Jed0vcela/Gas-Flow-Control-and-Logging-System/hydrogen - KiCad, 3D files/3D - lab assembly/spojka.png

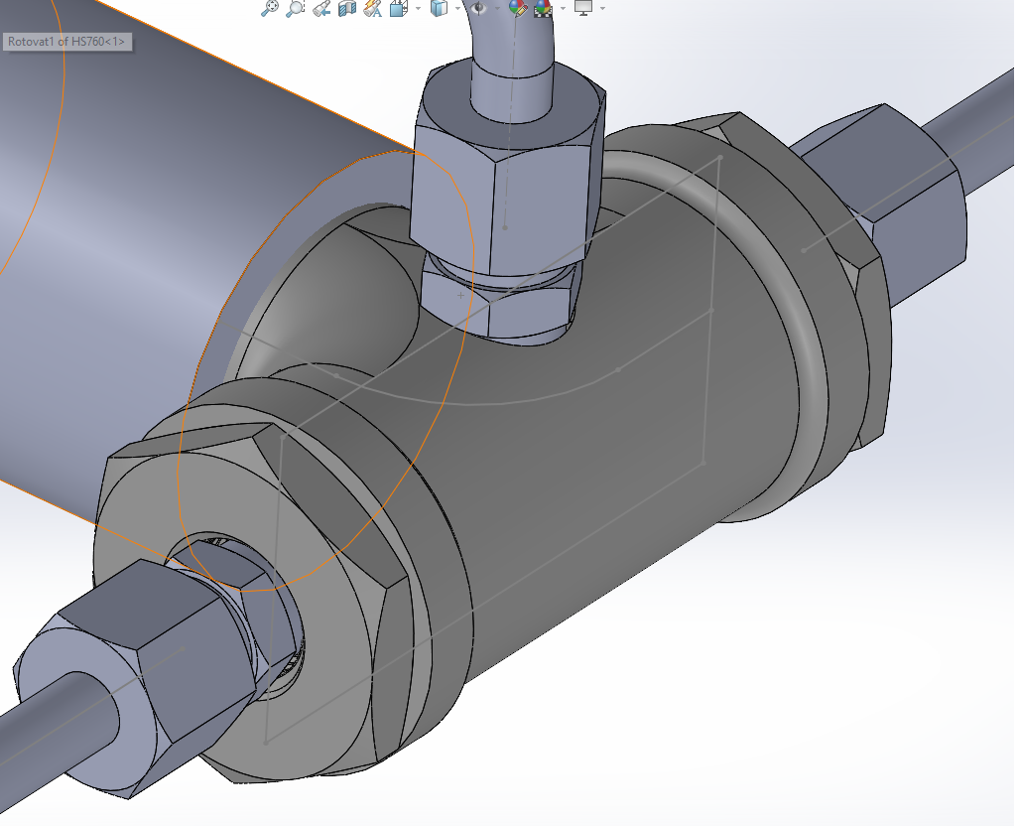
hydrogen - KiCad, 3D files/3D - lab assembly/spojka.png
