Jed0vcela/Gas-Flow-Control-and-Logging-System/hydrogen - KiCad, 3D files/3D - lab assembly/sestava.png

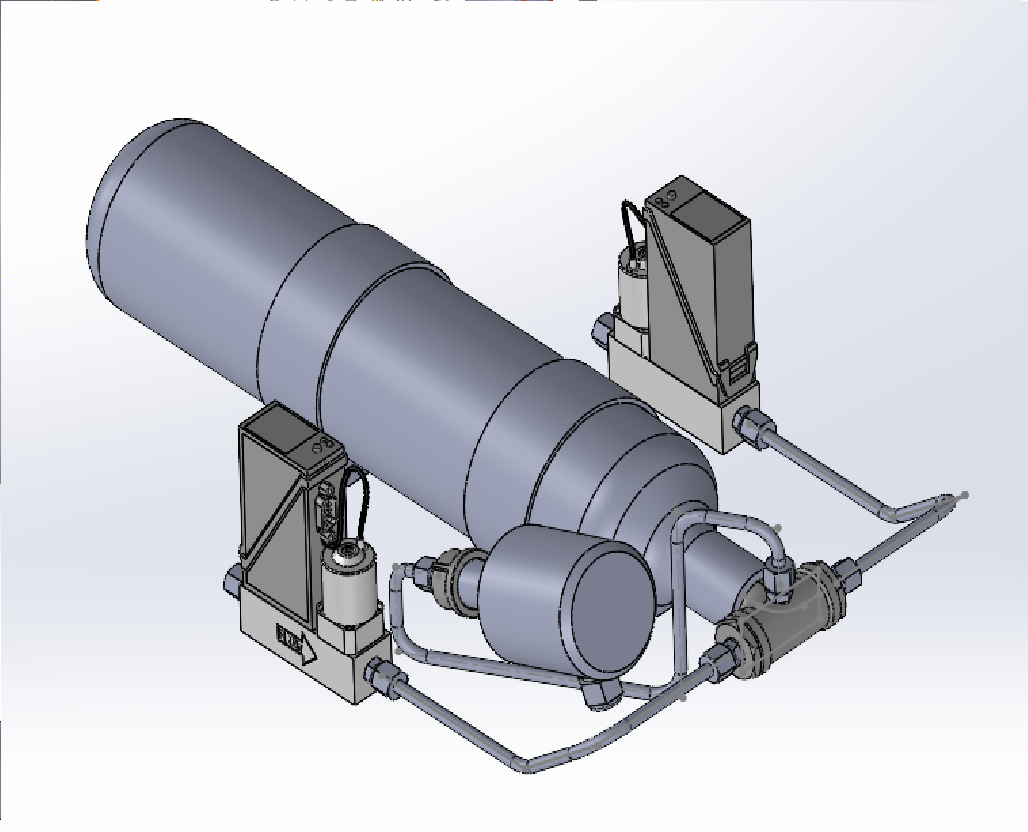
hydrogen - KiCad, 3D files/3D - lab assembly/sestava.png
