Jed0vcela/Gas-Flow-Control-and-Logging-System/hydrogen - KiCad, 3D files/3D - lab assembly/base.SLDPRT

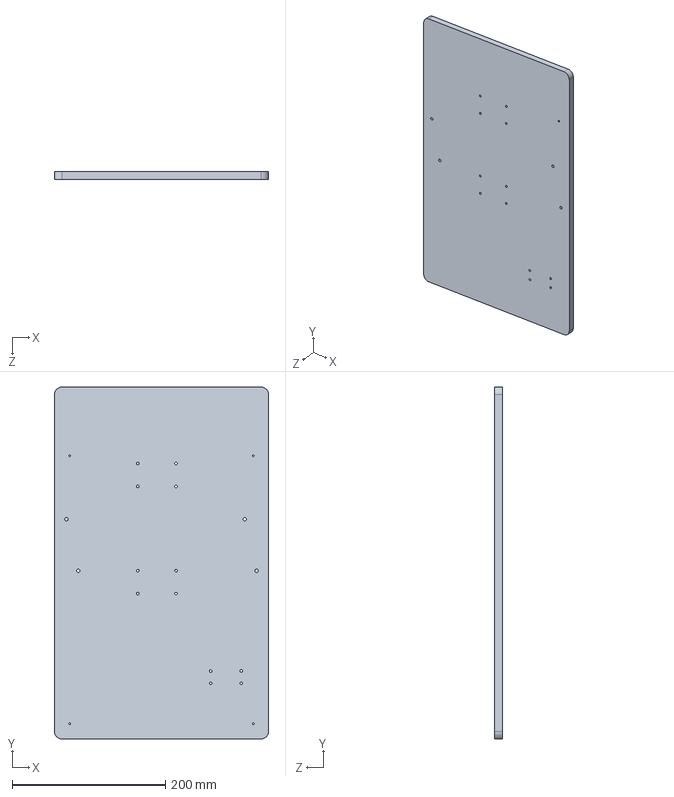
[picture p3: CAD file, 2026-06-02]
hydrogen - KiCad, 3D files/3D - lab assembly/base.SLDPRT
280.0 x 460.0 x 10.0 mm
