Jed0vcela/Gas-Flow-Control-and-Logging-System/hydrogen - KiCad, 3D files/REDragon-MX-ZT02.stp

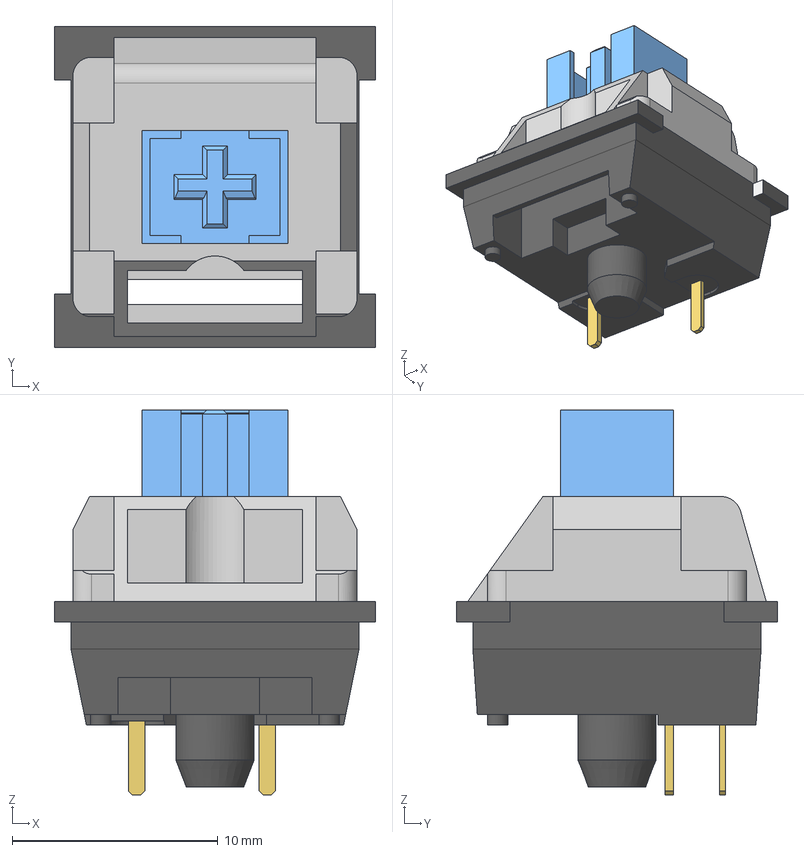
[picture p4: CAD file, 2026-06-02]
hydrogen - KiCad, 3D files/REDragon-MX-ZT02.stp
15.6 x 15.6 x 18.7 mm
Button
Pins
