Jed0vcela/Gas-Flow-Control-and-Logging-System/hydrogen - KiCad, 3D files/2,8 TFT SPI 240x320 V1.2 v2.step

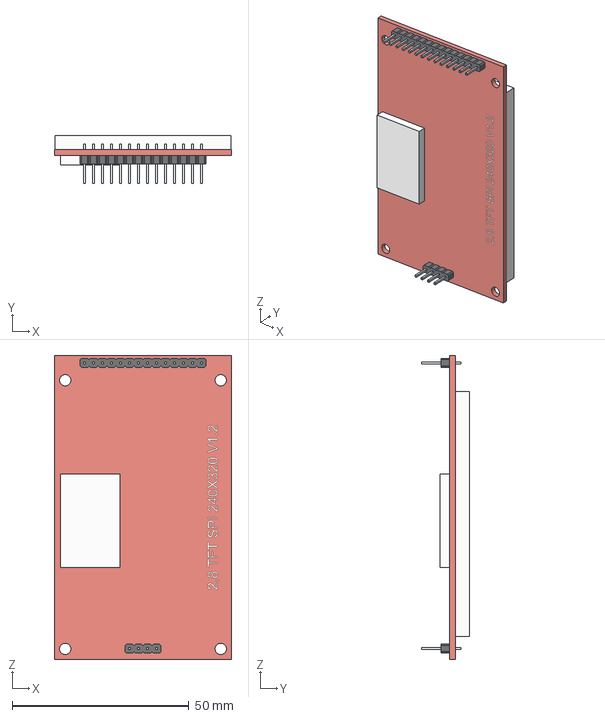
[picture p5: CAD file, 2026-06-02]
hydrogen - KiCad, 3D files/2,8 TFT SPI 240x320 V1.2 v2.step
50.2 x 13.6 x 86.0 mm
