Jed0vcela/Gas-Flow-Control-and-Logging-System/hydrogen - KiCad, 3D files/3D - lab assembly/PG-7 pruchodka.SLDPRT

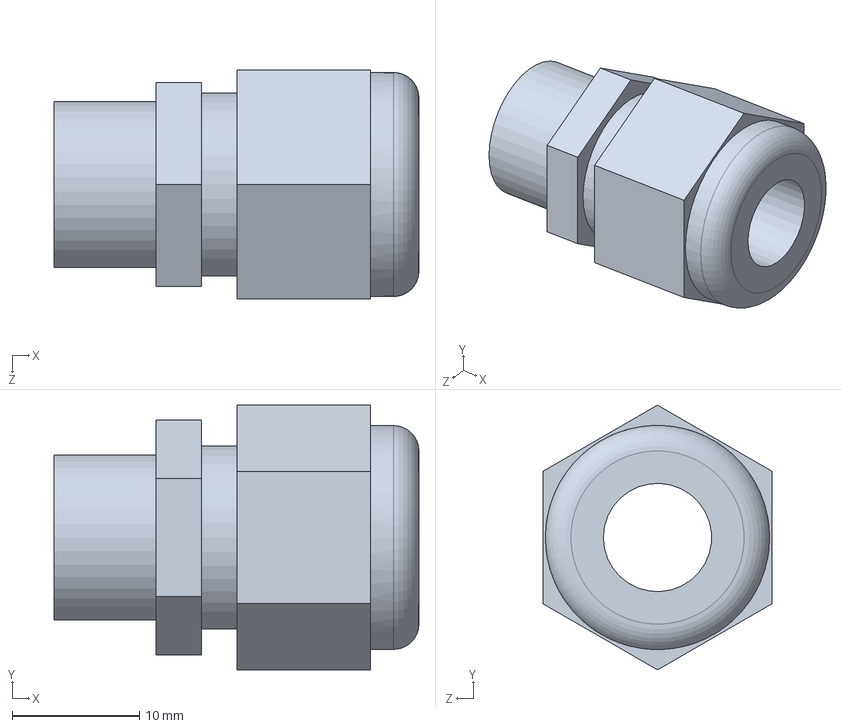
[picture p6: CAD file, 2026-06-02]
hydrogen - KiCad, 3D files/3D - lab assembly/PG-7 pruchodka.SLDPRT
28.7 x 20.8 x 18.0 mm
