Jed0vcela/Gas-Flow-Control-and-Logging-System/hydrogen - KiCad, 3D files/3D - lab assembly/cable clamp.SLDPRT

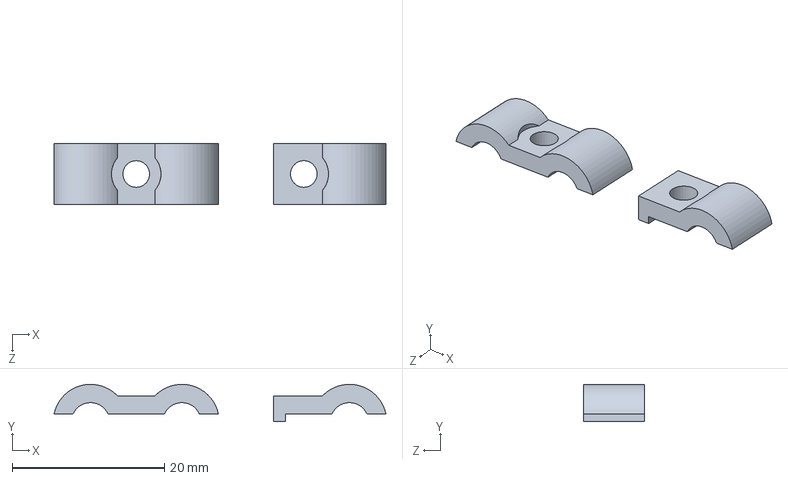
[picture p7: CAD file, 2026-06-02]
hydrogen - KiCad, 3D files/3D - lab assembly/cable clamp.SLDPRT
43.6 x 4.90 x 8.00 mm
