Jed0vcela/Gas-Flow-Control-and-Logging-System/hydrogen - KiCad, 3D files/3D/case bottom^hydrogen - bakalarka.STL

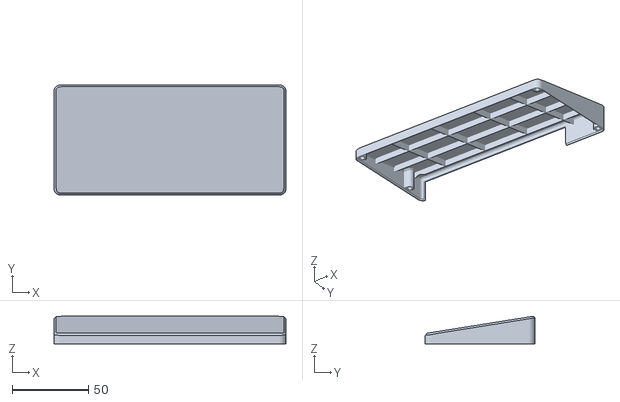
[picture p8: CAD file, 2026-06-02]
hydrogen - KiCad, 3D files/3D/case bottom^hydrogen - bakalarka.STL
152.0 x 72.0 x 18.0
