Jed0vcela/Gas-Flow-Control-and-Logging-System/hydrogen - KiCad, 3D files/3D - lab assembly/Assem1.STEP

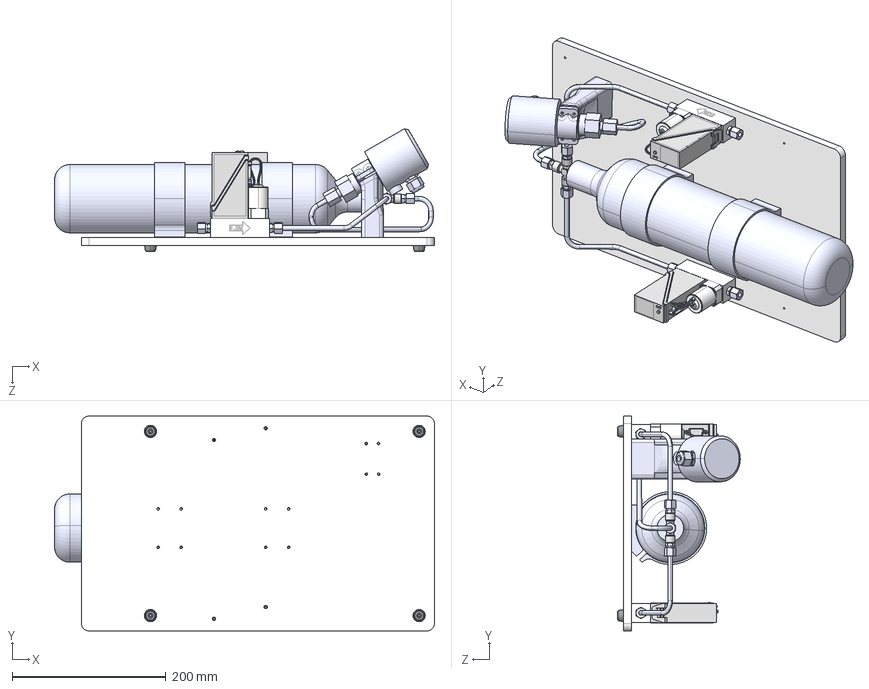
[picture p9: CAD file, 2026-06-02]
hydrogen - KiCad, 3D files/3D - lab assembly/Assem1.STEP
495.0 x 280.0 x 159.7 mm
HS760
tank holder x 2
ABB 261GS UKPN21
PG-7 pruchodka_Výchozí
right pipe
left pipe
pressure sensor pipe
MAS 06SR
9151K346_High-Pressure Nickel-Plated Brass Pipe Fitting_9151K346
06 tube G1-4 x 3
pressure gauge holder^Assem1
base
NF-004 FIX&FASTEN - Nožička x 4
