Jed0vcela/Gas-Flow-Control-and-Logging-System/hydrogen - KiCad, 3D files/3D/speaker holder^hydrogen - bakalarka.STL

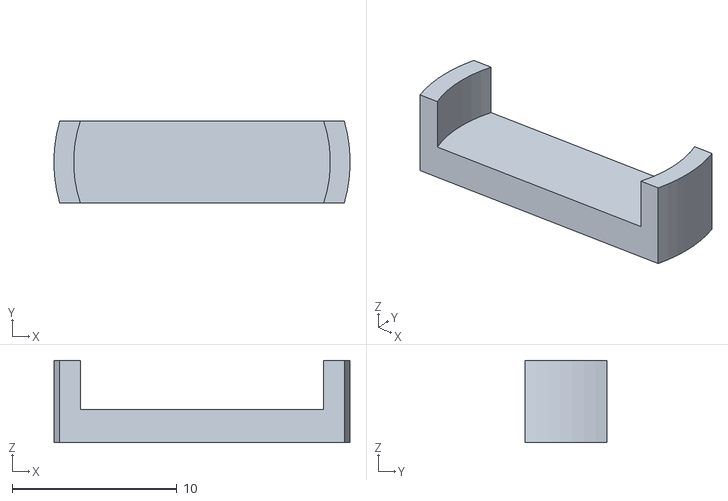
[picture p10: CAD file, 2026-06-02]
hydrogen - KiCad, 3D files/3D/speaker holder^hydrogen - bakalarka.STL
18.0 x 5.00 x 5.00
