Jed0vcela/Gas-Flow-Control-and-Logging-System/hydrogen - KiCad, 3D files/3D - lab assembly/hydrogen outlet holder v1.SLDPRT

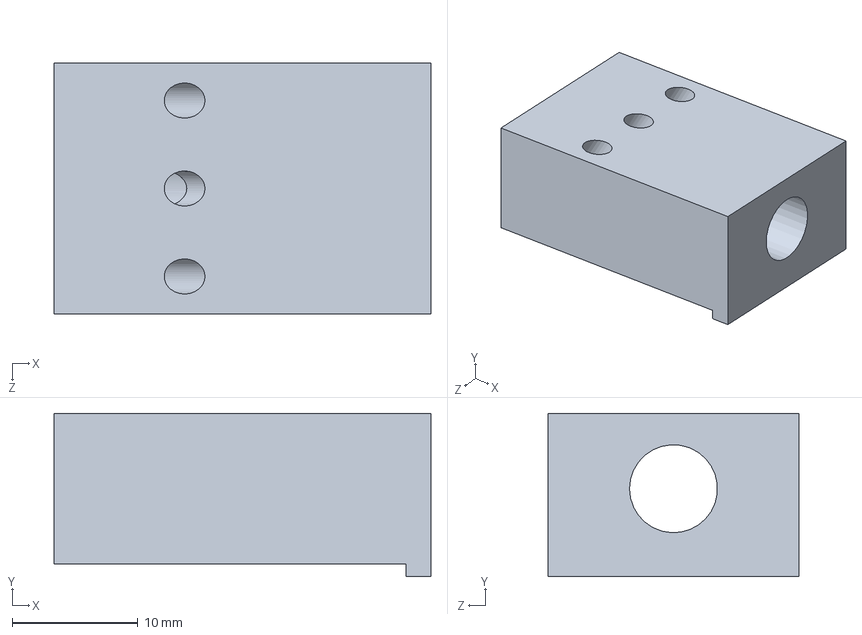
[picture p11: CAD file, 2026-06-02]
hydrogen - KiCad, 3D files/3D - lab assembly/hydrogen outlet holder v1.SLDPRT
30.0 x 13.0 x 20.0 mm
