Jed0vcela/Gas-Flow-Control-and-Logging-System/hydrogen - KiCad, 3D files/3D - lab assembly/MAS 06SR.SLDPRT

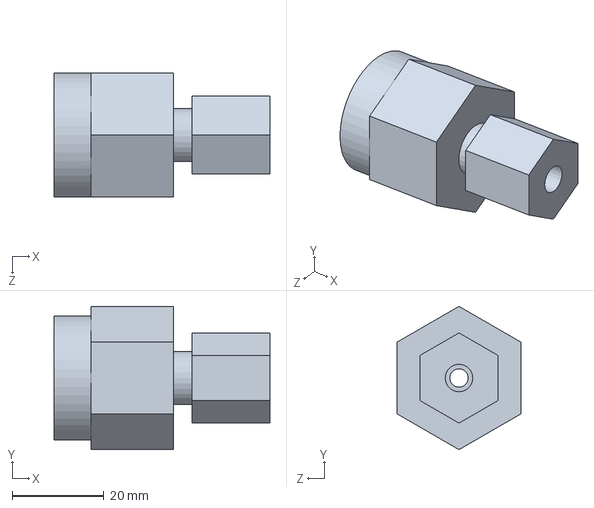
[picture p12: CAD file, 2026-06-02]
hydrogen - KiCad, 3D files/3D - lab assembly/MAS 06SR.SLDPRT
47.0 x 31.2 x 27.0 mm
