Jed0vcela/Gas-Flow-Control-and-Logging-System/hydrogen - KiCad, 3D files/3D - lab assembly/06 tube G1-4.SLDPRT

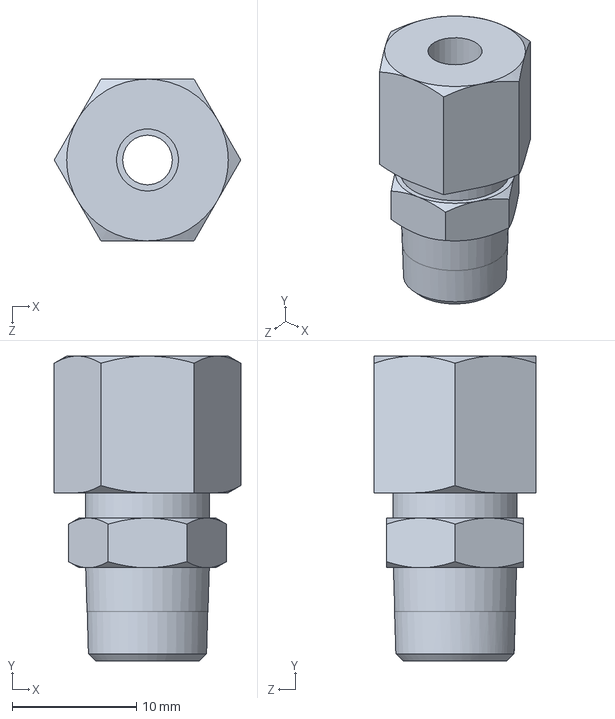
[picture p13: CAD file, 2026-06-02]
hydrogen - KiCad, 3D files/3D - lab assembly/06 tube G1-4.SLDPRT
15.0 x 24.5 x 13.0 mm
