Jed0vcela/Gas-Flow-Control-and-Logging-System/hydrogen - KiCad, 3D files/3D - lab assembly/tank holder.SLDPRT

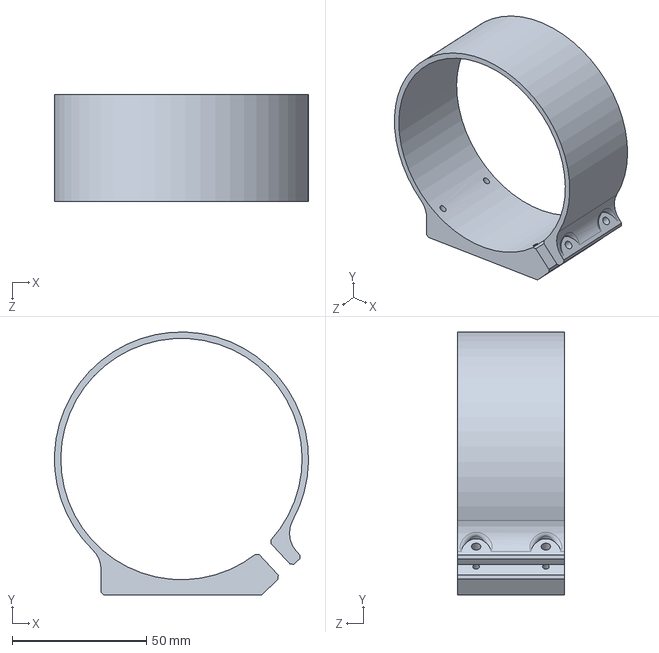
[picture p14: CAD file, 2026-06-02]
hydrogen - KiCad, 3D files/3D - lab assembly/tank holder.SLDPRT
94.7 x 98.1 x 40.0 mm
