Jed0vcela/Gas-Flow-Control-and-Logging-System/hydrogen - KiCad, 3D files/3D - lab assembly/left pipe.SLDPRT

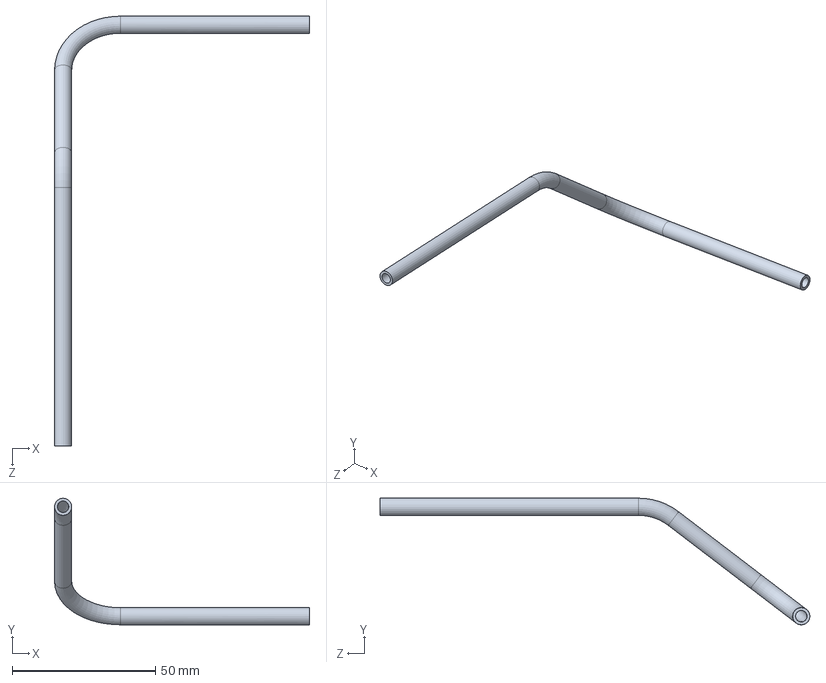
[picture p15: CAD file, 2026-06-02]
hydrogen - KiCad, 3D files/3D - lab assembly/left pipe.SLDPRT
89.0 x 44.2 x 150.0 mm
