Jed0vcela/Gas-Flow-Control-and-Logging-System/hydrogen - KiCad, 3D files/3D - lab assembly/HS760.SLDPRT

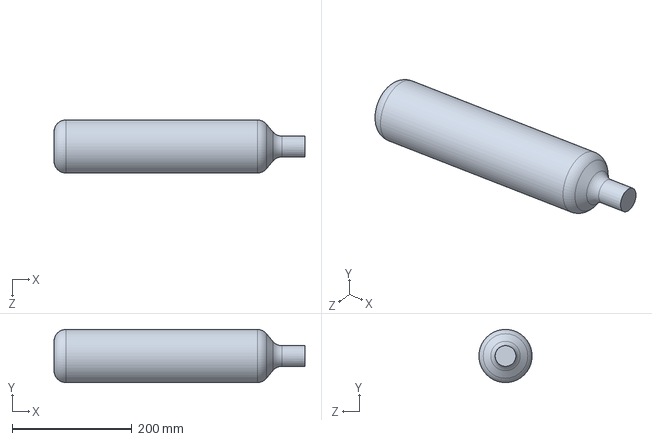
[picture p16: CAD file, 2026-06-02]
hydrogen - KiCad, 3D files/3D - lab assembly/HS760.SLDPRT
420.0 x 89.0 x 89.0 mm
