Jed0vcela/Gas-Flow-Control-and-Logging-System/hydrogen - KiCad, 3D files/3D - lab assembly/ABB 261GS UKPN21.SLDPRT

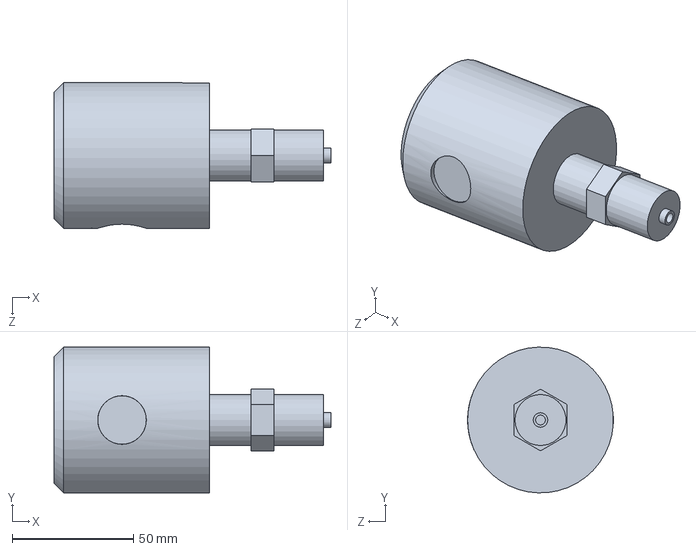
[picture p18: CAD file, 2026-06-02]
hydrogen - KiCad, 3D files/3D - lab assembly/ABB 261GS UKPN21.SLDPRT
114.0 x 60.0 x 60.0 mm
