Jed0vcela/Gas-Flow-Control-and-Logging-System/hydrogen - KiCad, 3D files/3D/case top^hydrogen - bakalarka.STL

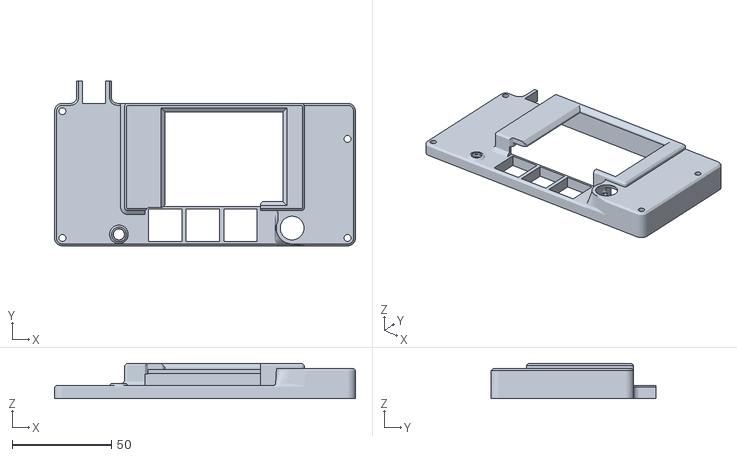
[picture p19: CAD file, 2026-06-02]
hydrogen - KiCad, 3D files/3D/case top^hydrogen - bakalarka.STL
152.0 x 83.2 x 17.7
