Jed0vcela/Gas-Flow-Control-and-Logging-System/hydrogen - KiCad, 3D files/3D/button handle v2.SLDPRT

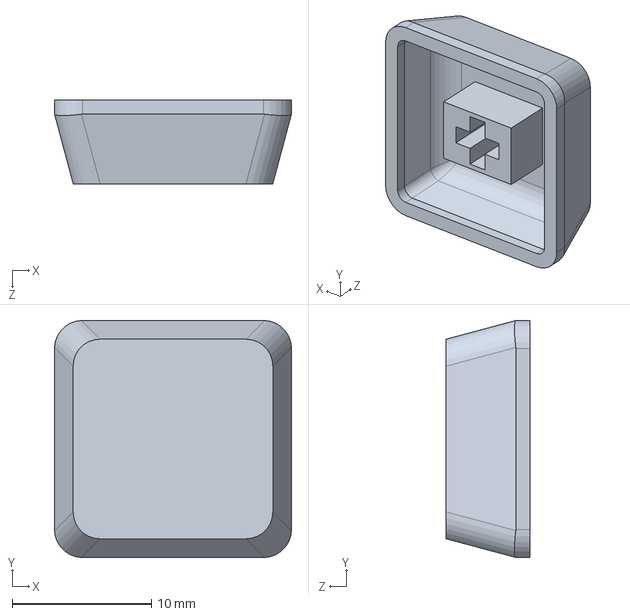
[picture p20: CAD file, 2026-06-02]
hydrogen - KiCad, 3D files/3D/button handle v2.SLDPRT
17.0 x 17.0 x 6.00 mm
