Jed0vcela/Gas-Flow-Control-and-Logging-System/hydrogen - KiCad, 3D files/3D/button handle tapered hole V2 NO_AMS hydrogen.SLDPRT

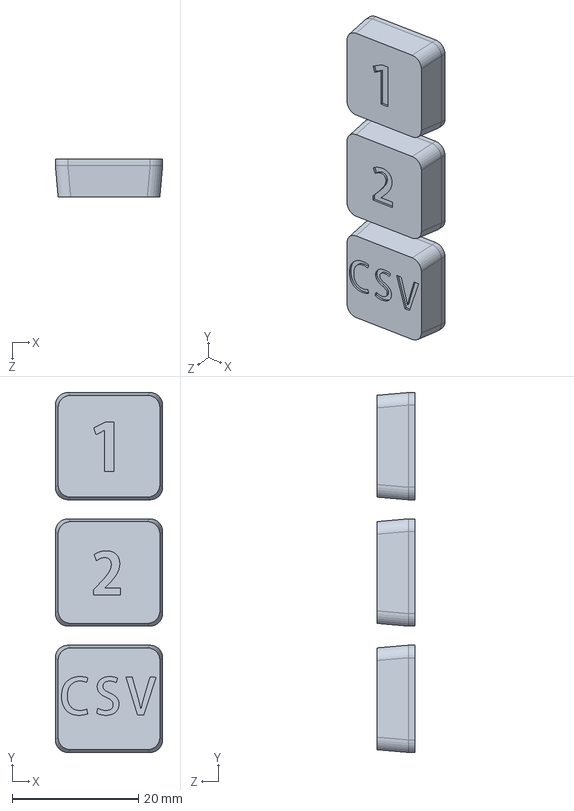
[picture p21: CAD file, 2026-06-02]
hydrogen - KiCad, 3D files/3D/button handle tapered hole V2 NO_AMS hydrogen.SLDPRT
17.0 x 57.0 x 6.00 mm
