Jed0vcela/Gas-Flow-Control-and-Logging-System/hydrogen - KiCad, 3D files/3D/hydrogen - bakalarka.SLDASM

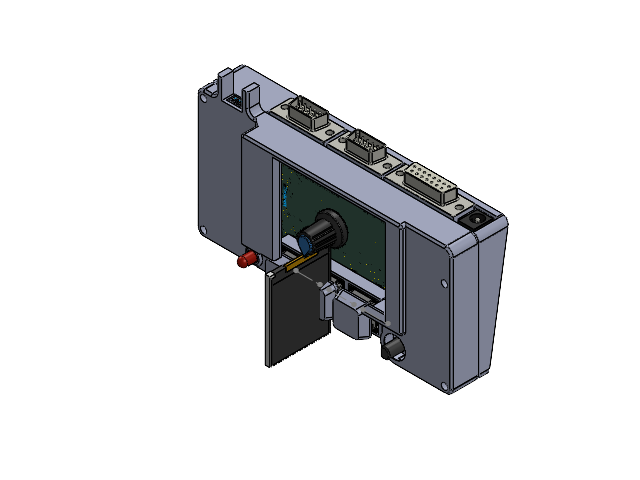
[picture p22: CAD file, 2026-06-02]
hydrogen - KiCad, 3D files/3D/hydrogen - bakalarka.SLDASM
Button x 3
Pins x 3
hydrogen - bakalarka 1.40.1
hydrogen - bakalarka 1.40.2
R_0603_1608Metric x 17
Buzzer_15x7.5RM7.6
PinHeader_1x14_P2.54mm_Vertical
LED_0603_1608Metric x 2
D_SMA x 4
PinHeader_1x04_P2.54mm_Vertical
LED_D5.0mm
C_1206_3216Metric x 2
SOT-23 x 2
C_0603_1608Metric x 22
PEC12R-4220F-S0024
CP_Radial_D6.3mm_P2.50mm x 2
SOIC-8_3.9x4.9mm_P1.27mm
R_LDR_5.1x4.3mm_P3.4mm_Vertical x 3
DSUB-9_Pins_Horizontal_P2.77x2.84mm_EdgePinOffset4.94mm_Housed_MountingHolesOffset4.94mm x 2
BarrelJack_GCT_DCJ200-10-A_Horizontal
BarrelJack_Horizontal
TSSOP-16_4.4x5mm_P0.65mm x 2
DSUB-15_Socket_Horizontal_P2.77x2.84mm_EdgePinOffset4.94mm_Housed_MountingHolesOffset4.94mm
hydrogen - bakalarka_copper
hydrogen - bakalarka_silkscreen
hydrogen - bakalarka_soldermask
hydrogen - bakalarka_PCB
case bottom^hydrogen - bakalarka
speaker holder^hydrogen - bakalarka
case top^hydrogen - bakalarka
button handle v2 x 3
