Jed0vcela/Gas-Flow-Control-and-Logging-System/(list of files, cad)

Other CAD files:
hydrogen - KiCad, 3D files/3D/PicoW.SLDASM
hydrogen - KiCad, 3D files/3D - lab assembly/f-201cv.SLDASM
hydrogen - KiCad, 3D files/3D/R_0603_1608Metric.SLDPRT
hydrogen - KiCad, 3D files/3D/Pins.SLDPRT
hydrogen - KiCad, 3D files/3D - lab assembly/pressure gauge holder TOP.SLDPRT
hydrogen - KiCad, 3D files/3D/Body.SLDPRT
hydrogen - KiCad, 3D files/3D - lab assembly/pressure gauge holder bottom.SLDPRT
hydrogen - KiCad, 3D files/3D/PinHeader_1x04_P2.54mm_Vertical.SLDPRT
hydrogen - KiCad, 3D files/3D/SOLID.SLDPRT
hydrogen - KiCad, 3D files/3D - lab assembly/pressure sensor pipe.SLDPRT
hydrogen - KiCad, 3D files/3D/LED_0603_1608Metric.SLDPRT
hydrogen - KiCad, 3D files/3D - lab assembly/hydrogen outlet holder v1 long.STL
hydrogen - KiCad, 3D files/3D/SOT-23.SLDPRT
hydrogen - KiCad, 3D files/3D/hydrogen - bakalarka_soldermask.SLDPRT
hydrogen - KiCad, 3D files/3D/R_LDR_5.1x4.3mm_P3.4mm_Vertical.SLDPRT
hydrogen - KiCad, 3D files/3D/PinHeader_1x14_P2.54mm_Vertical.SLDPRT
hydrogen - KiCad, 3D files/3D/TSSOP-16_4.4x5mm_P0.65mm.SLDPRT
hydrogen - KiCad, 3D files/3D/DSUB-9_Pins_Horizontal_P2.77x2.84mm_EdgePinOffset4.94mm_Housed_MountingHolesOffset4.94mm.SLDPRT
hydrogen - KiCad, 3D files/3D/Button.SLDPRT
hydrogen - KiCad, 3D files/3D/DSUB-15_Socket_Horizontal_P2.77x2.84mm_EdgePinOffset4.94mm_Housed_MountingHolesOffset4.94mm.SLDPRT
hydrogen - KiCad, 3D files/3D - lab assembly/NF-004 FIX&FASTEN - Nožička.SLDPRT
hydrogen - KiCad, 3D files/3D/C_1206_3216Metric.SLDPRT
hydrogen - KiCad, 3D files/3D/hydrogen - bakalarka_PCB.SLDPRT
hydrogen - KiCad, 3D files/3D - lab assembly/right pipe.SLDPRT
hydrogen - KiCad, 3D files/3D/SOIC-8_3.9x4.9mm_P1.27mm.SLDPRT
hydrogen - KiCad, 3D files/3D - lab assembly/pressure gauge holder bottom1.SLDPRT
hydrogen - KiCad, 3D files/3D/Buzzer_15x7.5RM7.6.SLDPRT
hydrogen - KiCad, 3D files/3D - lab assembly/Part97_6_1.SLDPRT
hydrogen - KiCad, 3D files/3D/CP_Radial_D6.3mm_P2.50mm.SLDPRT
hydrogen - KiCad, 3D files/3D/hydrogen - bakalarka 1.40.1.SLDPRT
hydrogen - KiCad, 3D files/3D/hydrogen - bakalarka 1.40.2.SLDPRT
hydrogen - KiCad, 3D files/3D/C_0603_1608Metric.SLDPRT
hydrogen - KiCad, 3D files/3D/D_SMA.SLDPRT
hydrogen - KiCad, 3D files/3D/hydrogen - bakalarka_copper.SLDPRT
hydrogen - KiCad, 3D files/3D/hydrogen - bakalarka_silkscreen.SLDPRT
hydrogen - KiCad, 3D files/3D/PEC12R-4220F-S0024.SLDPRT
hydrogen - KiCad, 3D files/3D/BarrelJack_GCT_DCJ200-10-A_Horizontal.SLDPRT
hydrogen - KiCad, 3D files/3D/BarrelJack_Horizontal.SLDPRT
hydrogen - KiCad, 3D files/3D/LED_D5.0mm.SLDPRT
hydrogen - KiCad, 3D files/3D/COMPOUND.SLDPRT
hydrogen - KiCad, 3D files/3D - lab assembly/4978K144_British Standard Low-Pressure Bronze Pipe Fitting.SLDPRT
hydrogen - KiCad, 3D files/3D - lab assembly/4978K172_Low-Pressure Pipe Fitting.SLDPRT
hydrogen - KiCad, 3D files/3D - lab assembly/9151K346_High-Pressure Nickel-Plated Brass Pipe Fitting.SLDPRT
hydrogen - KiCad, 3D files/3D - lab assembly/9162K144_Low-Pressure Chrome-Plated Brass Pipe Fitting.SLDPRT
hydrogen - KiCad, 3D files/3D - lab assembly/Assem1.SLDASM
hydrogen - KiCad, 3D files/3D - lab assembly/base.SLDDRW
hydrogen - KiCad, 3D files/3D - lab assembly/cable clamp.STL
hydrogen - KiCad, 3D files/3D - lab assembly/hydrogen outlet holder v1.STL
hydrogen - KiCad, 3D files/3D - lab assembly/left pipe.STL
hydrogen - KiCad, 3D files/3D - lab assembly/pressure gauge holder TOP.STL
hydrogen - KiCad, 3D files/3D - lab assembly/pressure gauge holder bottom1.STL
hydrogen - KiCad, 3D files/3D - lab assembly/pressure sensor pipe.STL
hydrogen - KiCad, 3D files/3D - lab assembly/right pipe.STL
hydrogen - KiCad, 3D files/3D - lab assembly/tank holder.STL
hydrogen - KiCad, 3D files/3D/2,8 TFT SPI 240x320 V1.2 v2.SLDASM
hydrogen - KiCad, 3D files/3D/REDragon-MX-ZT02.SLDASM
hydrogen - KiCad, 3D files/3D/button handle tapered hole V2 NO_AMS hydrogen.STL
