Jed0vcela/Gas-Flow-Control-and-Logging-System/hydrogen - KiCad, 3D files/3D - lab assembly/base.pdf

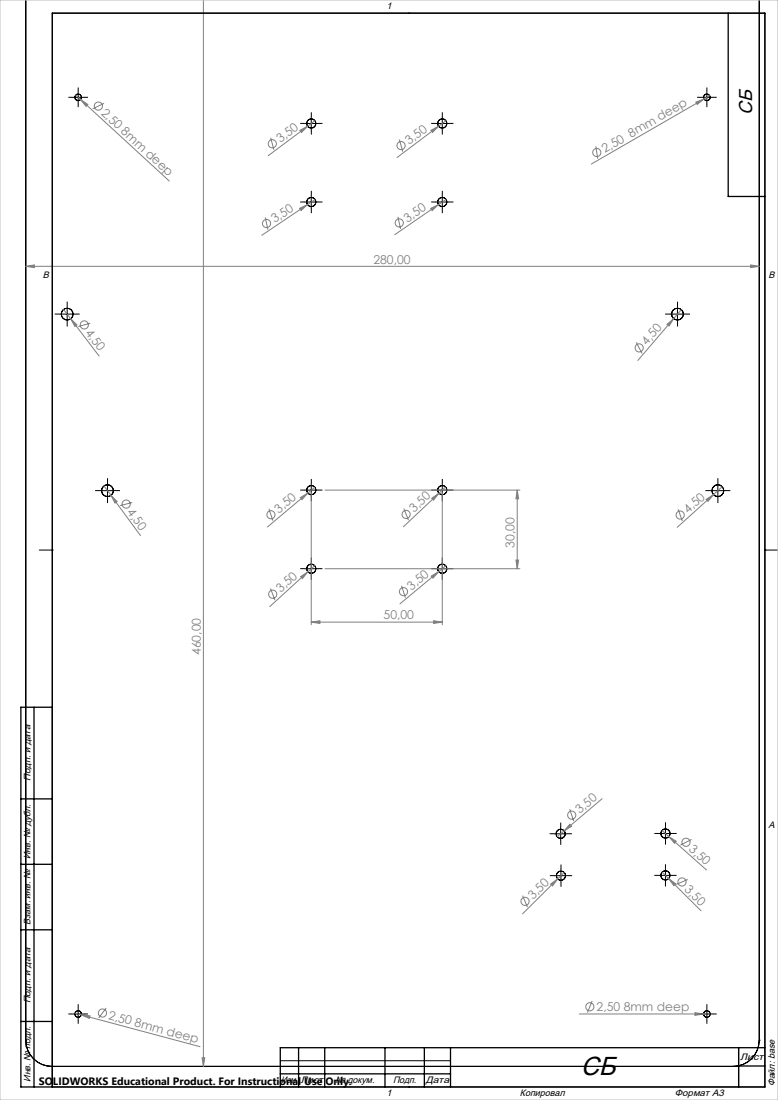
[picture p23: page 1]
2,50 8mm deep; 2,50 8mm deep 2,50 8mm deep 460,00; Инв. № подл.; № докум.; Подп.; Дата; Формат А3; Файл: base

Подп. и дата Взам. инв. № Инв. № дубл. Подп. и дата

SOLIDWORKS Educational Product. For Instructional Use Only.
