Jed0vcela/Gas-Flow-Control-and-Logging-System/hydrogen - KiCad, 3D files/hydrogen - bakalarka.pdf

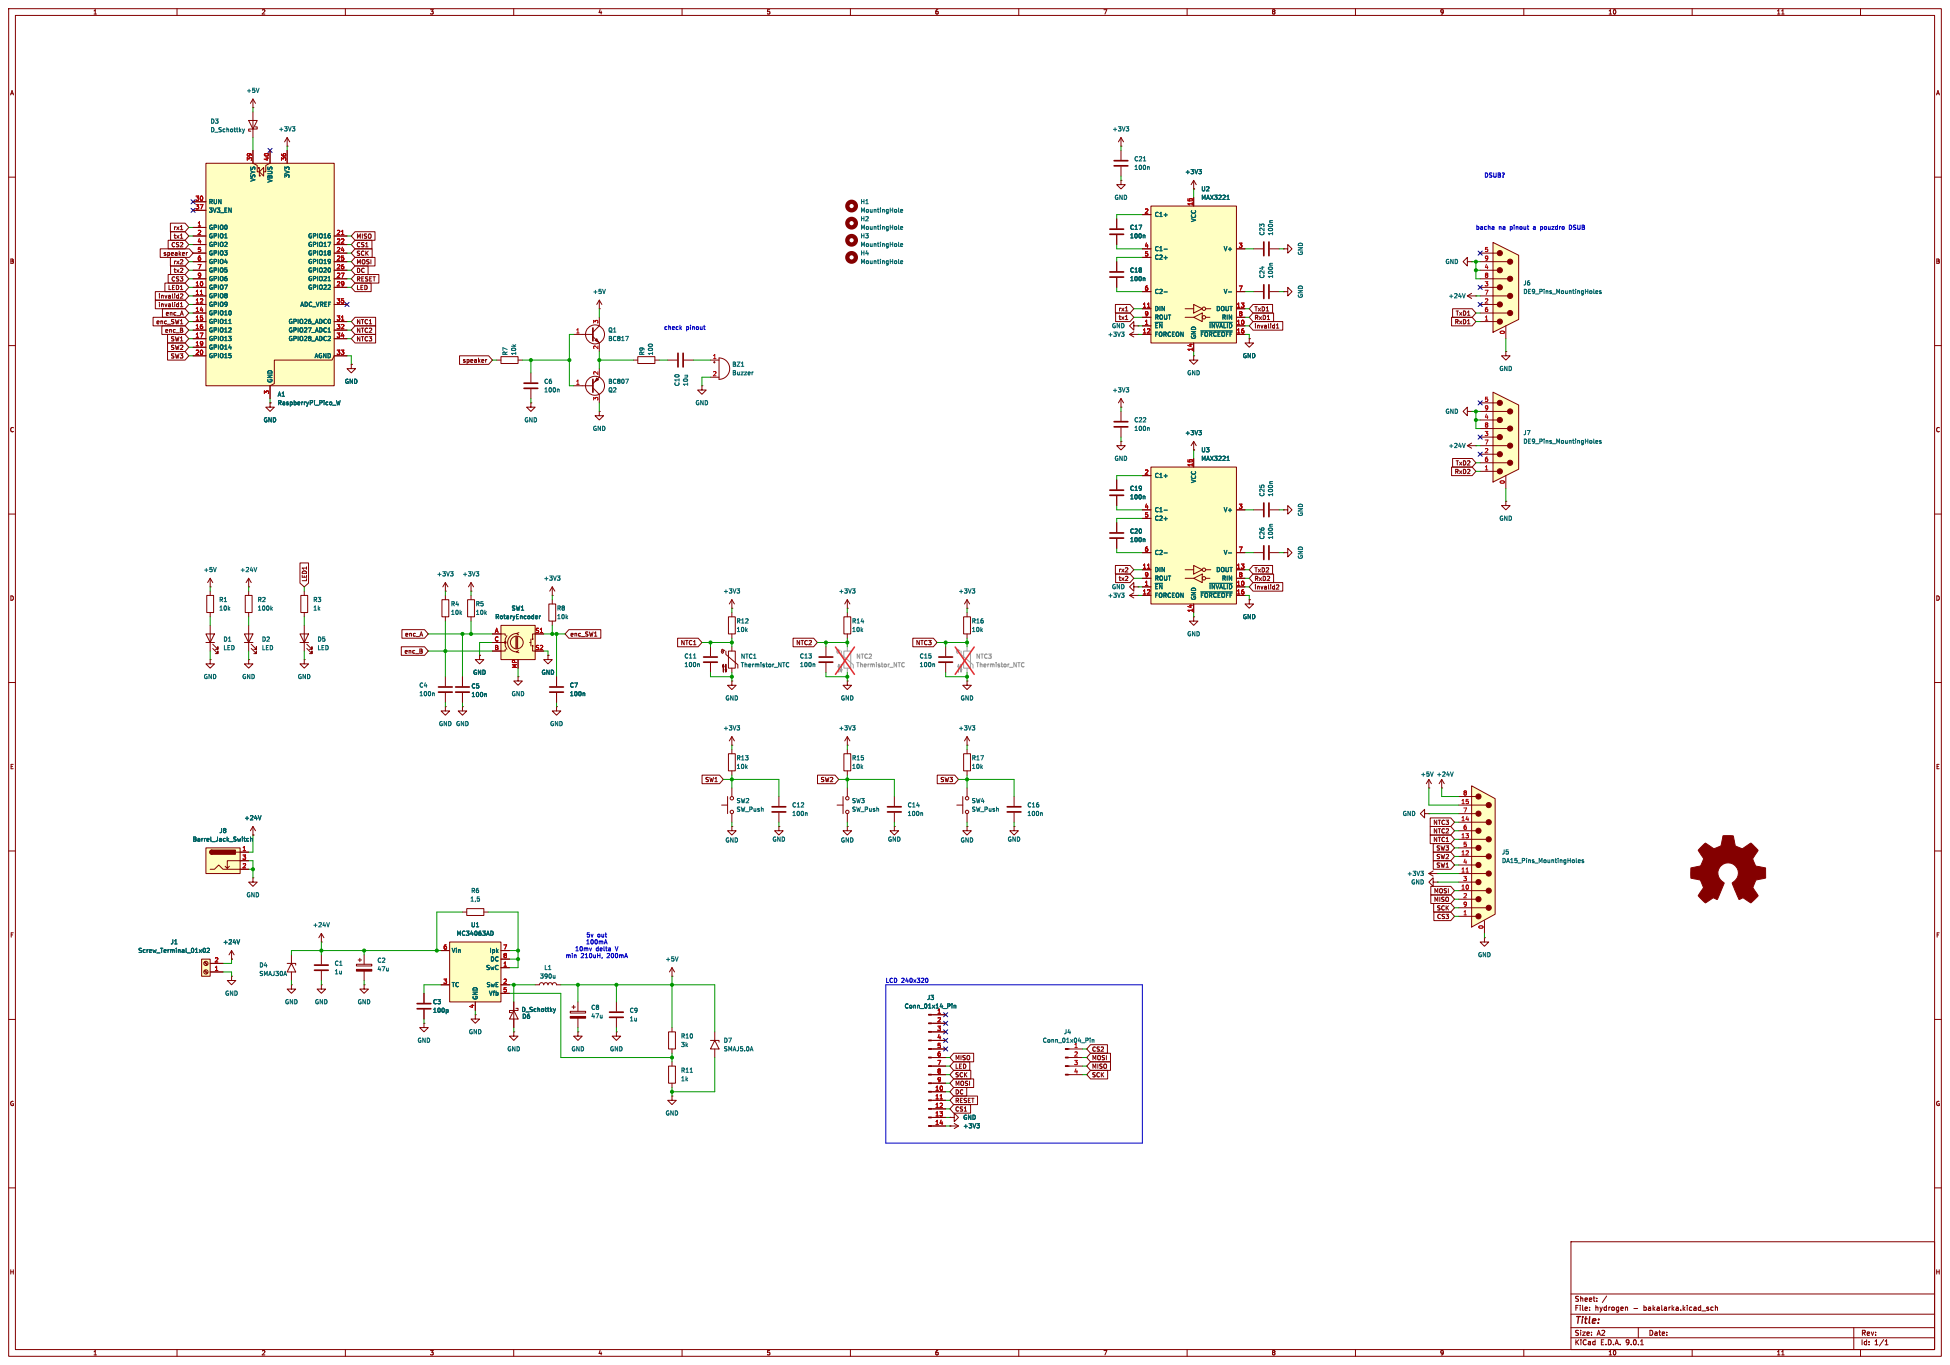
[picture p24: page 1]

bacha na pinout a pouzdro DSUB

Ipk 7 DC 8 SwC 1 SwE 2 Vfb 5 U1 MC34063AD

Ipk 7 DC 8 SwC 1 SwE 2 Vfb 5 C3
