Jed0vcela/Gas-Flow-Control-and-Logging-System/hydrogen - KiCad, 3D files/hydrogen - bakalarka.kicad_pcb

## KiCad design hydrogen - KiCad, 3D files/hydrogen - bakalarka.kicad_pcb (2026-06-02)

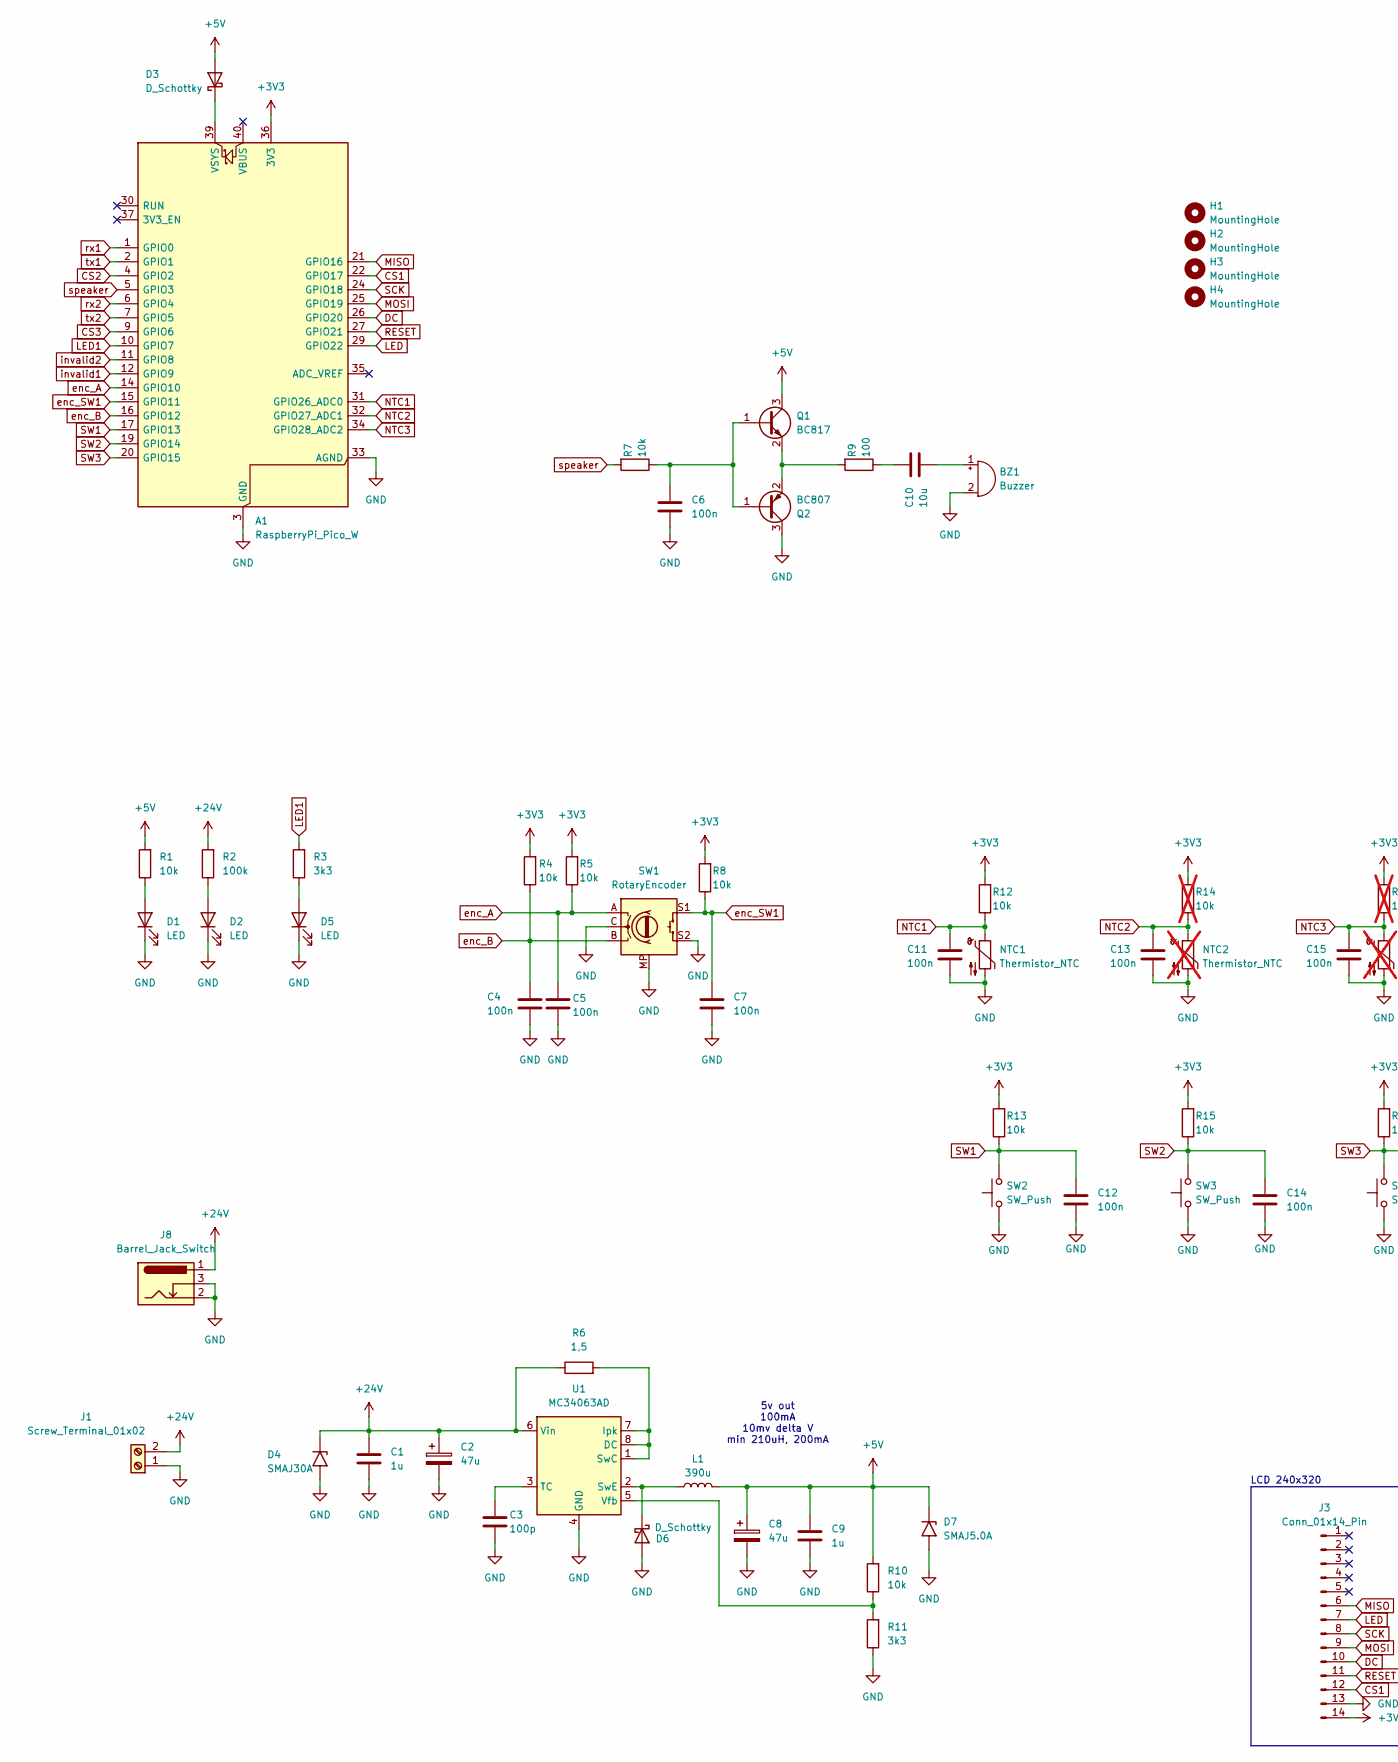
[picture p25: schematic hydrogen - bakalarka.kicad_sch, part in row 1, column 1]

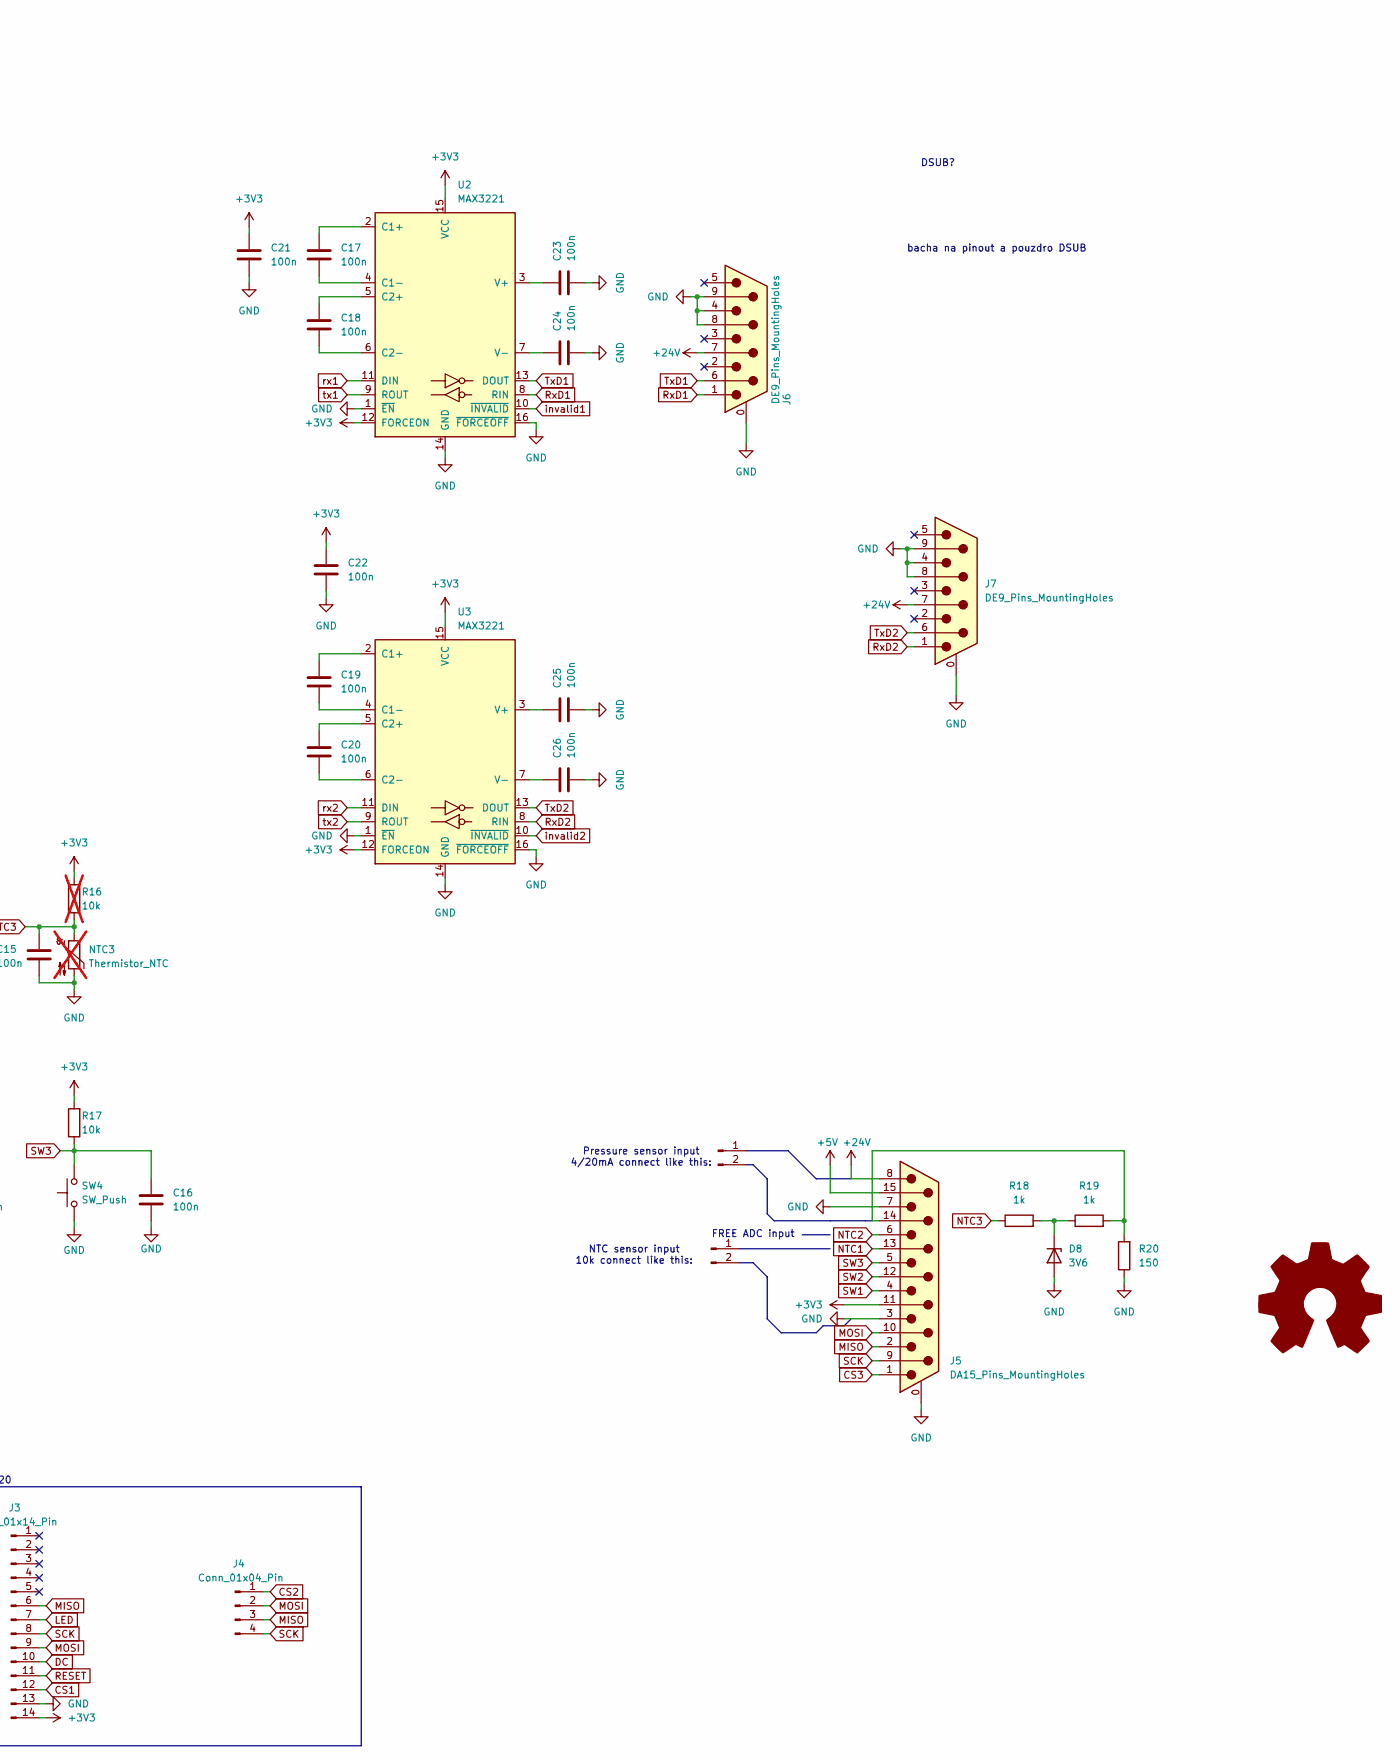
[picture p26: schematic hydrogen - bakalarka.kicad_sch, part in row 1, column 2]

Parts:
A1: RaspberryPi_Pico_W; RaspberryPi_Pico_W_SMD_HandSolder
BZ1: Buzzer; Buzzer_15x7.5RM7.6
C1, C9: 1u; C_1206_3216Metric
C2, C8: 47u; CP_Radial_D6.3mm_P2.50mm
C3: 100p; C_0603_1608Metric
C4, C5, C6, C7, C11, C12, C13, C14, C15, C16, C17, C18, C19, C20, C21, C22, C23, C24, C25, C26: 100n; C_0603_1608Metric
C10: 10u; C_0603_1608Metric
D1, D2: LED; LED_0603_1608Metric
D3, D6: D_Schottky; D_SMA
D4: SMAJ30A; D_SMA
D5: LED; LED_D5.0mm
D7: SMAJ5.0A; D_SMA
D8: 3V6
H1, H2, H3, H4: MountingHole; MountingHole_3.2mm_M3_DIN965
J1: Screw_Terminal_01x02; TerminalBlock_RND_205-00287_1x02_P5.08mm_Horizontal
J2, J9: Conn_01x02_Pin
J3: Conn_01x14_Pin; PinHeader_1x14_P2.54mm_Vertical
J4: Conn_01x04_Pin; PinHeader_1x04_P2.54mm_Vertical
J5: DA15_Pins_MountingHoles; DSUB-15_Socket_Horizontal_P2.77x2.84mm_EdgePinOffset4.94mm_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
J6, J7: DE9_Pins_MountingHoles; DSUB-9_Pins_Horizontal_P2.77x2.84mm_EdgePinOffset4.94mm_Hou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
J8: Barrel_Jack_Switch; BarrelJack_GCT_DCJ200-10-A_Horizontal
L1: 390u; L_12x12mm_H8mm
NTC1: Thermistor_NTC; R_LDR_5.1x4.3mm_P3.4mm_Vertical
NTC2, NTC3: Thermistor_NTC; R_LDR_5.1x4.3mm_P3.4mm_Vertical; not fitted
Q1: BC817; SOT-23
Q2: BC807; SOT-23
R1, R4, R5, R7, R8, R10, R12, R13, R15, R17: 10k; R_0603_1608Metric
R2: 100k; R_0603_1608Metric
R3, R11: 3k3; R_0603_1608Metric
R6: 1,5; R_0603_1608Metric
R9: 100; R_0603_1608Metric
R14, R16: 10k; R_0603_1608Metric; not fitted
R18, R19: 1k
R20: 150
SW1: RotaryEncoder; RotaryEncoder_Alps_EC11E-Switch_Vertical_H20mm
SW2, SW3, SW4: SW_Push; SW_Cherry_MX_1.00u_PCB
U1: MC34063AD; SOIC-8_3.9x4.9mm_P1.27mm
U2, U3: MAX3221; TSSOP-16_4.4x5mm_P0.65mm

Connections:
+3V3: A1.36 (3V3), C21.1, C22.1, J3.14, J5.11 (P111), R4.2, R5.2, R8.2, R12.2, R13.2, R14.2, R15.2, R16.2, R17.2, U2.12 (FORCEON), U2.15 (VCC), U3.12 (FORCEON), U3.15 (VCC)
+5V: C8.1, C9.1, D3.2 (A), D7.1 (A1), J5.15, L1.2, Q1.3 (C), R1.2, R10.2
+24V: C1.1, C2.1, D4.1 (A1), J1.2, J5.8, J6.7, J7.7, J8.1, R2.2, R6.1, U1.6 (Vin)
CS1: A1.22 (GPIO17), J3.12
CS2: A1.4 (GPIO2), J4.1
CS3: A1.9 (GPIO6), J5.1
DC: A1.26 (GPIO20), J3.10
GND: A1.3 (GND), A1.8 (GND), A1.13 (GND), A1.18 (GND), A1.23 (GND), A1.28 (GND), A1.33 (AGND), A1.38 (GND), BZ1.2 (-), C1.2, C2.2, C3.2, C4.2, C5.2, C6.2, C7.2, C8.2, C9.2, C11.2, C12.2, C13.2, C14.2, C15.2, C16.2, C21.2, C22.2, C23.2, C24.2, C25.2, C26.2, D1.1 (K), D2.1 (K), D4.2 (A2), D5.1 (K), D6.2 (A), D7.2 (A2), D8.2 (A), J1.1, J3.13, J5.0 (PAD), J5.3, J5.7, J6.0 (PAD), J6.4, J6.8, J6.9, J7.0 (PAD), J7.4, J7.8, J7.9, J8.2, J8.3, NTC1.2, NTC2.2, NTC3.2, Q2.3 (C), R11.1, R20.1, SW1.C, SW1.MP, SW1.S2, SW2.1, SW3.1, SW4.1, U1.4 (GND), U2.1 (~EN), U2.14 (GND), U2.16 (~FORCEOFF), U3.1 (~EN), U3.14 (GND), U3.16 (~FORCEOFF)
LED: A1.29 (GPIO22), J3.7
LED1: A1.10 (GPIO7), R3.2
MISO: A1.21 (GPIO16), J3.6, J4.3, J5.2
MOSI: A1.25 (GPIO19), J3.9, J4.2, J5.10
NTC1: A1.31 (GPIO26_ADC0), C11.1, J5.13, NTC1.1, R12.1
NTC2: A1.32 (GPIO27_ADC1), C13.1, J5.6, NTC2.1, R14.1
NTC3: A1.34 (GPIO28_ADC2), C15.1, J5.14, NTC3.1, R16.1, R18.1, R19.2, R20.2
unnamed: A1.39 (VSYS), D3.1 (K)
unnamed: BZ1.1 (+), C10.2
unnamed: C10.1, R9.1
unnamed: D1.2 (A), R1.1
unnamed: D2.2 (A), R2.1
unnamed: D5.2 (A), R3.1
unnamed: D6.1 (K), L1.1, U1.2 (SwE)
unnamed: D8.1 (K), R18.2, R19.1
unnamed: C6.1, Q1.1 (B), Q2.1 (B), R7.1
unnamed: Q1.2 (E), Q2.2 (E), R9.2
unnamed: R6.2, U1.1 (SwC), U1.7 (Ipk), U1.8 (DC)
unnamed: C3.1, U1.3 (TC)
unnamed: R10.1, R11.2, U1.5 (Vfb)
unnamed: C17.2, U2.2 (C1+)
unnamed: C17.1, U2.4 (C1-)
unnamed: C18.2, U2.5 (C2+)
unnamed: C18.1, U2.6 (C2-)
unnamed: C23.1, U2.3 (V+)
unnamed: C24.1, U2.7 (V-)
unnamed: C19.2, U3.2 (C1+)
unnamed: C19.1, U3.4 (C1-)
unnamed: C20.2, U3.5 (C2+)
unnamed: C20.1, U3.6 (C2-)
unnamed: C25.1, U3.3 (V+)
unnamed: C26.1, U3.7 (V-)
RESET: A1.27 (GPIO21), J3.11
RxD1: J6.1, U2.8 (RIN)
RxD2: J7.1, U3.8 (RIN)
SCK: A1.24 (GPIO18), J3.8, J4.4, J5.9
SW1: A1.17 (GPIO13), C12.1, J5.4, R13.1, SW2.2
SW2: A1.19 (GPIO14), C14.1, J5.12, R15.1, SW3.2
SW3: A1.20 (GPIO15), C16.1, J5.5, R17.1, SW4.2
TxD1: J6.6, U2.13 (DOUT)
TxD2: J7.6, U3.13 (DOUT)
enc_A: A1.14 (GPIO10), C5.1, R5.1, SW1.A
enc_B: A1.16 (GPIO12), C4.1, R4.1, SW1.B
enc_SW1: A1.15 (GPIO11), C7.1, R8.1, SW1.S1
invalid1: A1.12 (GPIO9), U2.10 (~INVALID)
invalid2: A1.11 (GPIO8), U3.10 (~INVALID)
rx1: A1.1 (GPIO0), U2.11 (DIN)
rx2: A1.6 (GPIO4), U3.11 (DIN)
speaker: A1.5 (GPIO3), R7.2
tx1: A1.2 (GPIO1), U2.9 (ROUT)
tx2: A1.7 (GPIO5), U3.9 (ROUT)

Notes on the sheet:
LCD 240x320
FREE ADC input
5v out 100mA 10mv delta V min 210uH, 200mA
Pressure sensor input 4/20mA connect like this:
NTC sensor input 10k connect like this:
bacha na pinout a pouzdro DSUB
DSUB?

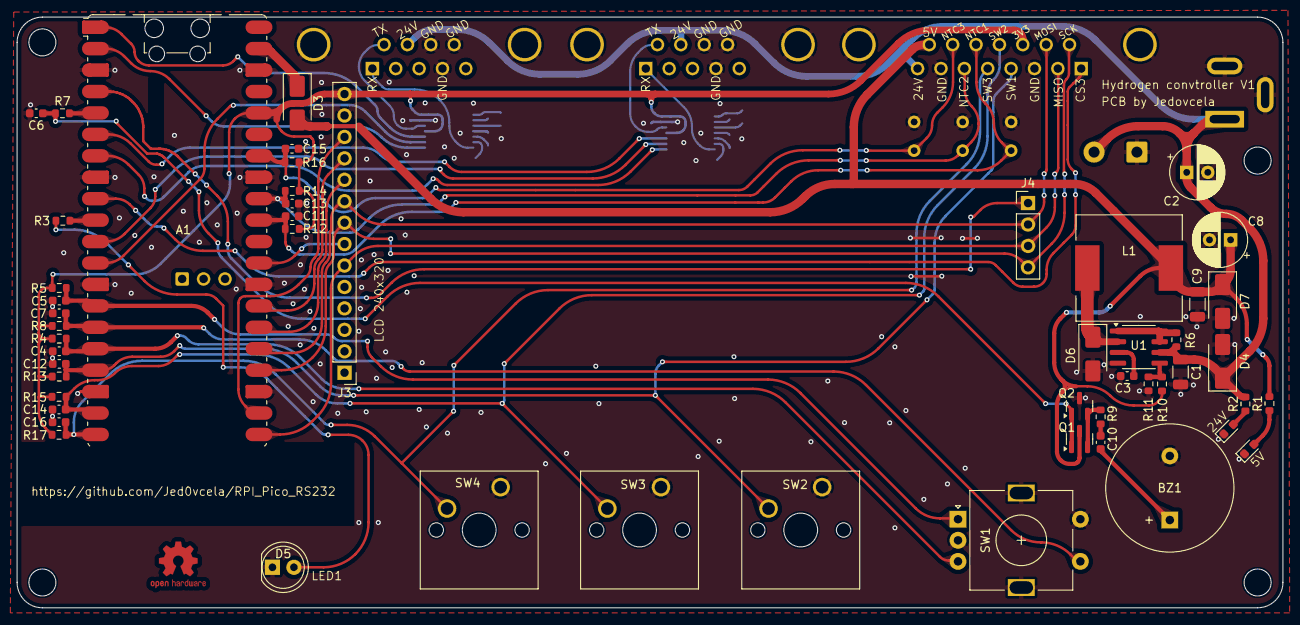
[picture p27: board hydrogen - bakalarka.kicad_pcb from above]

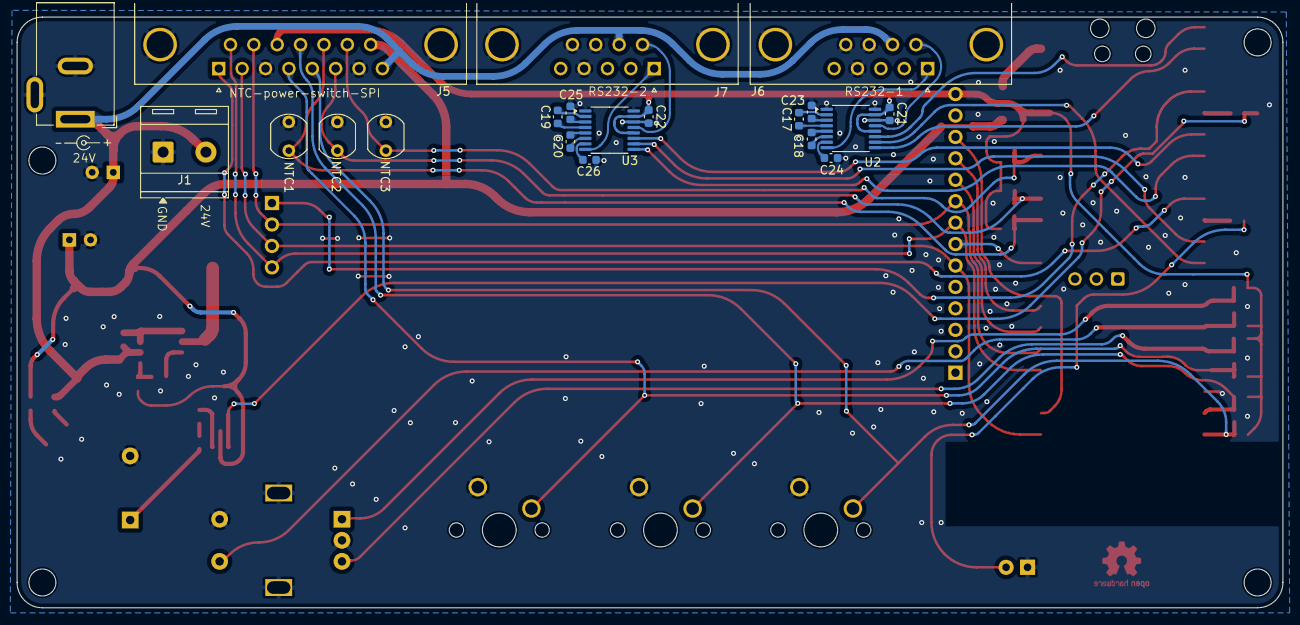
[picture p28: board hydrogen - bakalarka.kicad_pcb from below]

Board: 2 copper layers, 150.0 x 70.0 mm, 76 parts (20 on the bottom side), 58 nets.
