Jed0vcela/Gas-Flow-Control-and-Logging-System/(commit log)

2026-06-02 initial Kicad and 3D files upload
    KiCad files and 3D SolidWorks files upload
    [06 tube G1-4.SLDPRT, 2,8 TFT SPI 240x320 V1.2 v2.SLDASM, 2,8 TFT SPI 240x320 V1.2 v2.step, 4978K144_British Standard Low-Pressure Bronze Pipe Fitting.SLDPRT, 4978K172_Low-Pressure Pipe Fitting.SLDPRT, 9151K346_High-Pressure Nickel-Plated Brass Pipe Fitting.SLDPRT, 9162K144_Low-Pressure Chrome-Plated Brass Pipe Fitting.SLDPRT, ABB 261GS UKPN21.SLDPRT]
2026-06-02 rename
    dir rename
    [06 tube G1-4.SLDPRT, 2,8 TFT SPI 240x320 V1.2 v2.SLDASM, 2,8 TFT SPI 240x320 V1.2 v2.step, 4978K144_British Standard Low-Pressure Bronze Pipe Fitting.SLDPRT, 4978K172_Low-Pressure Pipe Fitting.SLDPRT, 9151K346_High-Pressure Nickel-Plated Brass Pipe Fitting.SLDPRT, 9162K144_Low-Pressure Chrome-Plated Brass Pipe Fitting.SLDPRT, ABB 261GS UKPN21.SLDPRT]
